patzf/Serial_Link_EMC_Demo/README.md

# Serial_Link_EMC_Demo
Run common serial interfaces across different cables
<!-- ! [Preview of PCB](hw/rendering1.png)  -->
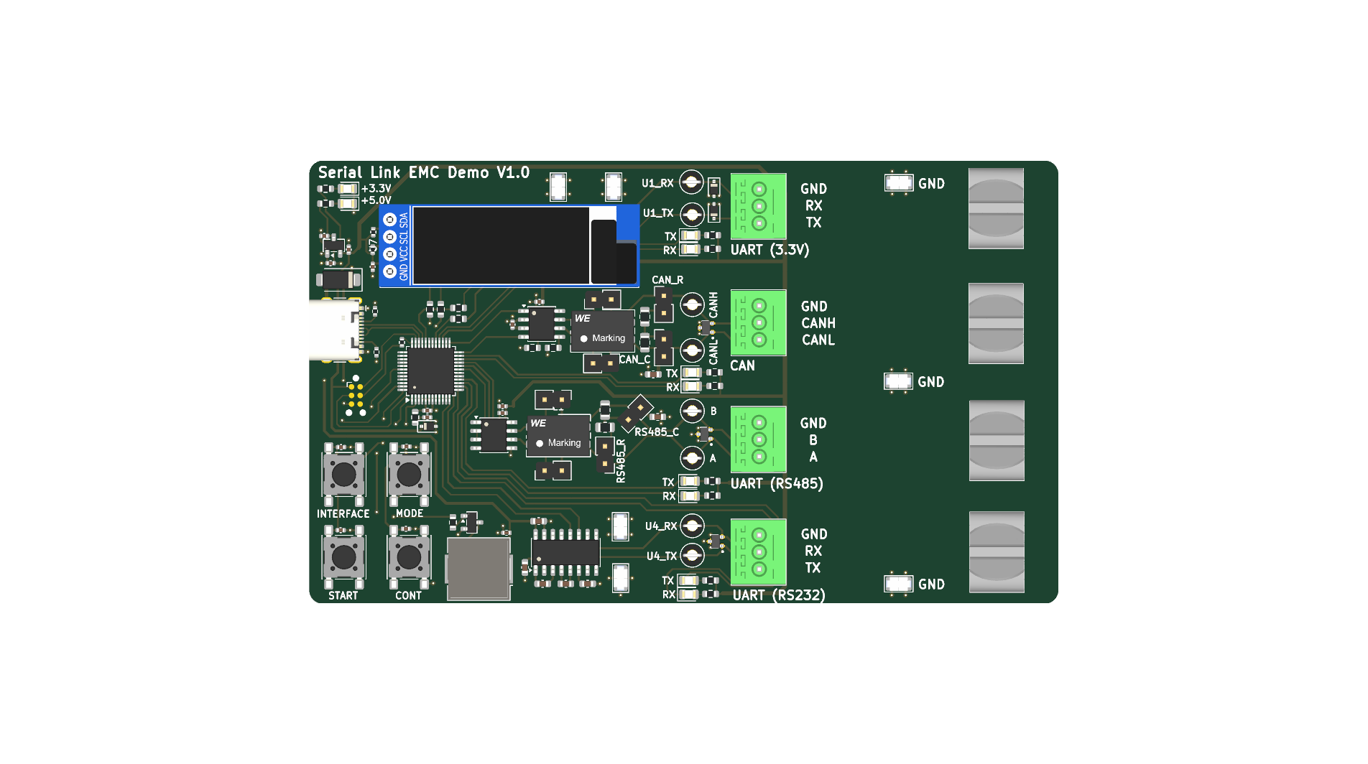
[picture p1: hw/Design-Outputs/pcb_rendering/main.png]
Preview of PCB
