patzf/Serial_Link_EMC_Demo/hw/img/catBW.png

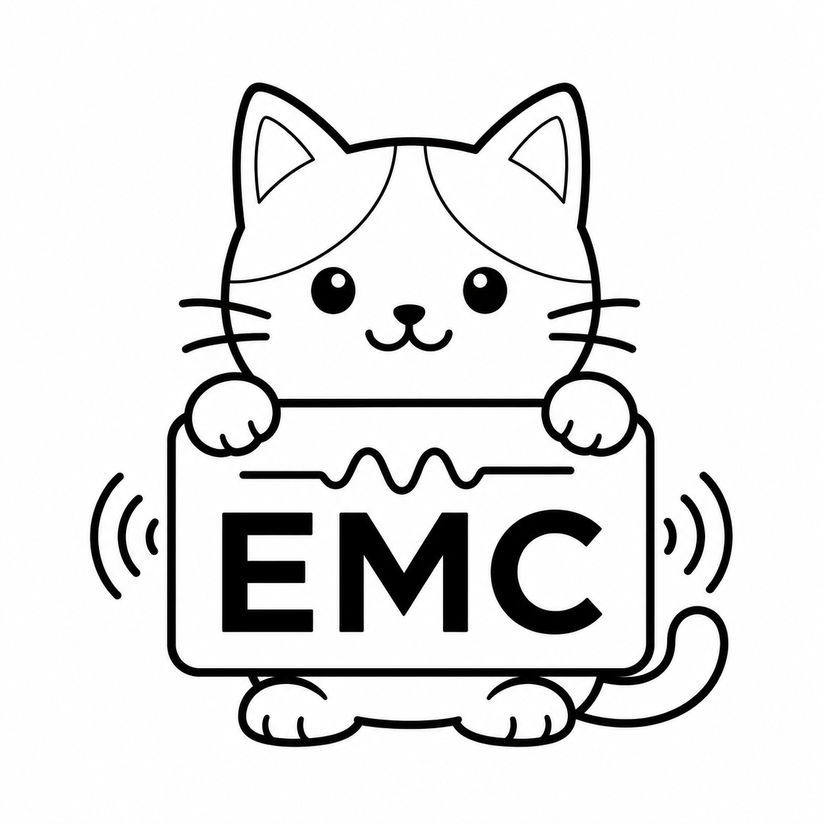
hw/img/catBW.png
