patzf/Serial_Link_EMC_Demo/hw/Design-Outputs/IFboard.pdf

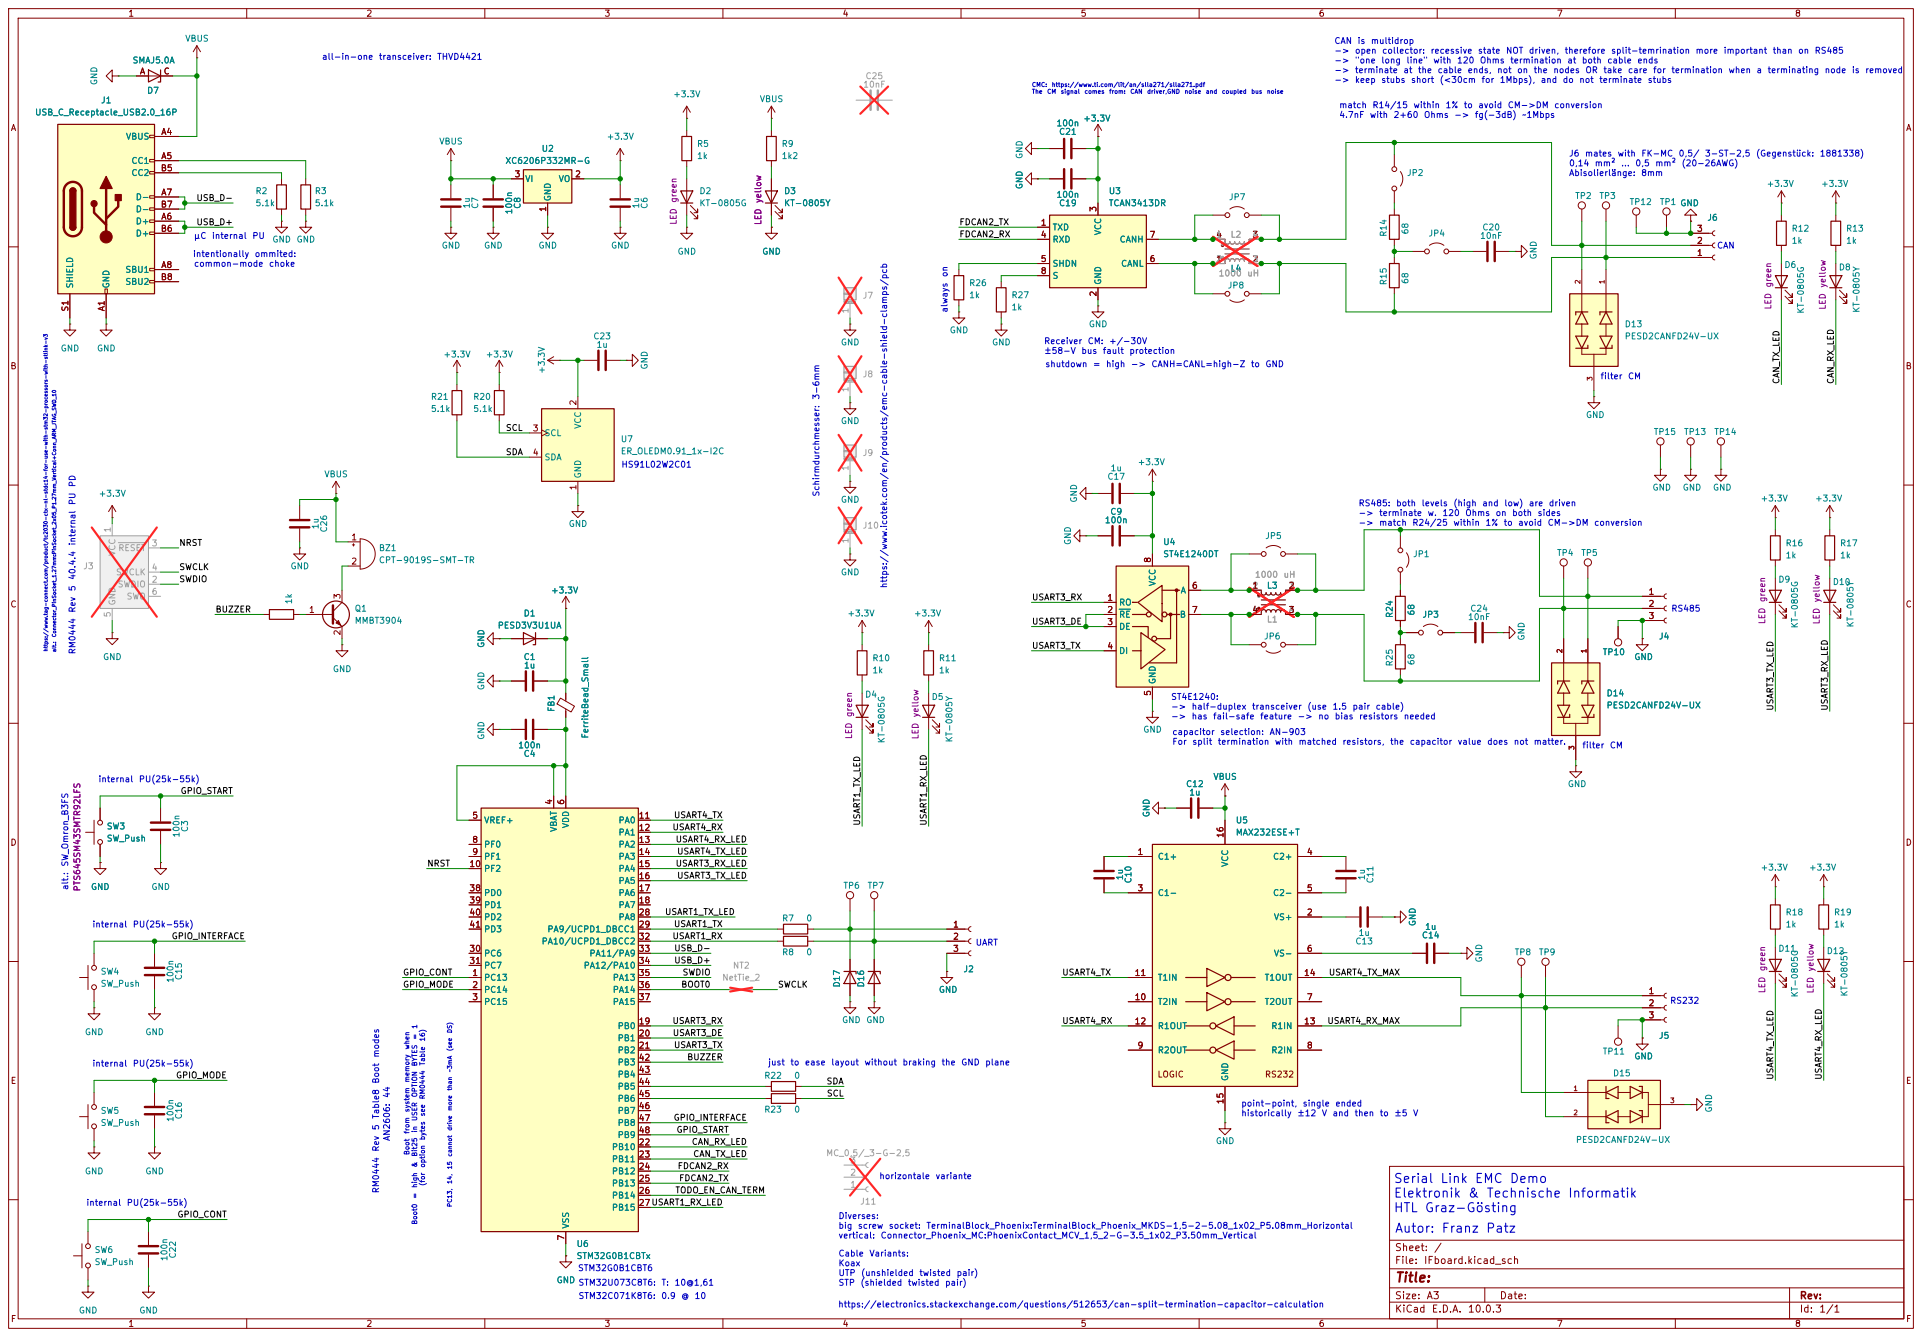
[picture p3: page 1]

all-in-one transceiver: THVD4421

match R14/15 within 1% to avoid CM->DM conversion 4.7nF with 2+60 Ohms -> fg(-3dB) ~1Mbps AN2606: 44

J6 mates with FK-MC 0,5/ 3-ST-2,5 (Gegenstück: 1881338)
0,14 mm² ... 0,5 mm² (20-26AWG)
Abisolierlänge: 8mm
TP3 GND

intentionally ommited: common-mode choke µC internal PU
internal PU(25k-55k) alt.: SW_Omron_B3FS https://www.tag-connect.com/product/tc2030-ctx-nl-stdc14-for-use-with-stm32-processors-with-stlink-v3

Receiver CM: +/-30V ±58-V bus fault protection always on https://www.icotek.com/en/products/emc-cable-shield-clamps/pcb

shutdown = high -> CANH=CANL=high-Z to GND

For split termination with matched resistors, the capacitor value does not matter. ST4E1240: -> half-duplex transceiver (use 1.5 pair cable) -> has fail-safe feature -> no bias resistors needed

filter CM Serial Link EMC Demo

UART https://electronics.stackexchange.com/questions/512653/can-split-termination-capacitor-calculation Diverses: big screw socket: TerminalBlock_Phoenix:TerminalBlock_Phoenix_MKDS-1,5-2-5.08_1x02_P5.08mm_Horizontal vertical: Connector_Phoenix_MC:PhoenixContact_MCV_1,5_2-G-3.5_1x02_P3.50mm_Vertical STM32G0B1CBT6

RS232 Boot from system memory when Boot0 = high & Bit25 in USER OPTION BYTES = 1 (for option bytes see RM0444 Table 16)

just to ease layout without braking the GND plane RM0444 Rev 5 Table8 Boot modes

point-point, single ended
historically ±12 V and then to ±5 V

Size: A3 | Rev:
KiCad E.D.A. 10.0.3 | Id: 1/1 | F Date:
