patzf/Serial_Link_EMC_Demo/hw/IFboard.kicad_pcb

## KiCad design hw/IFboard.kicad_pcb (2026-06-04)

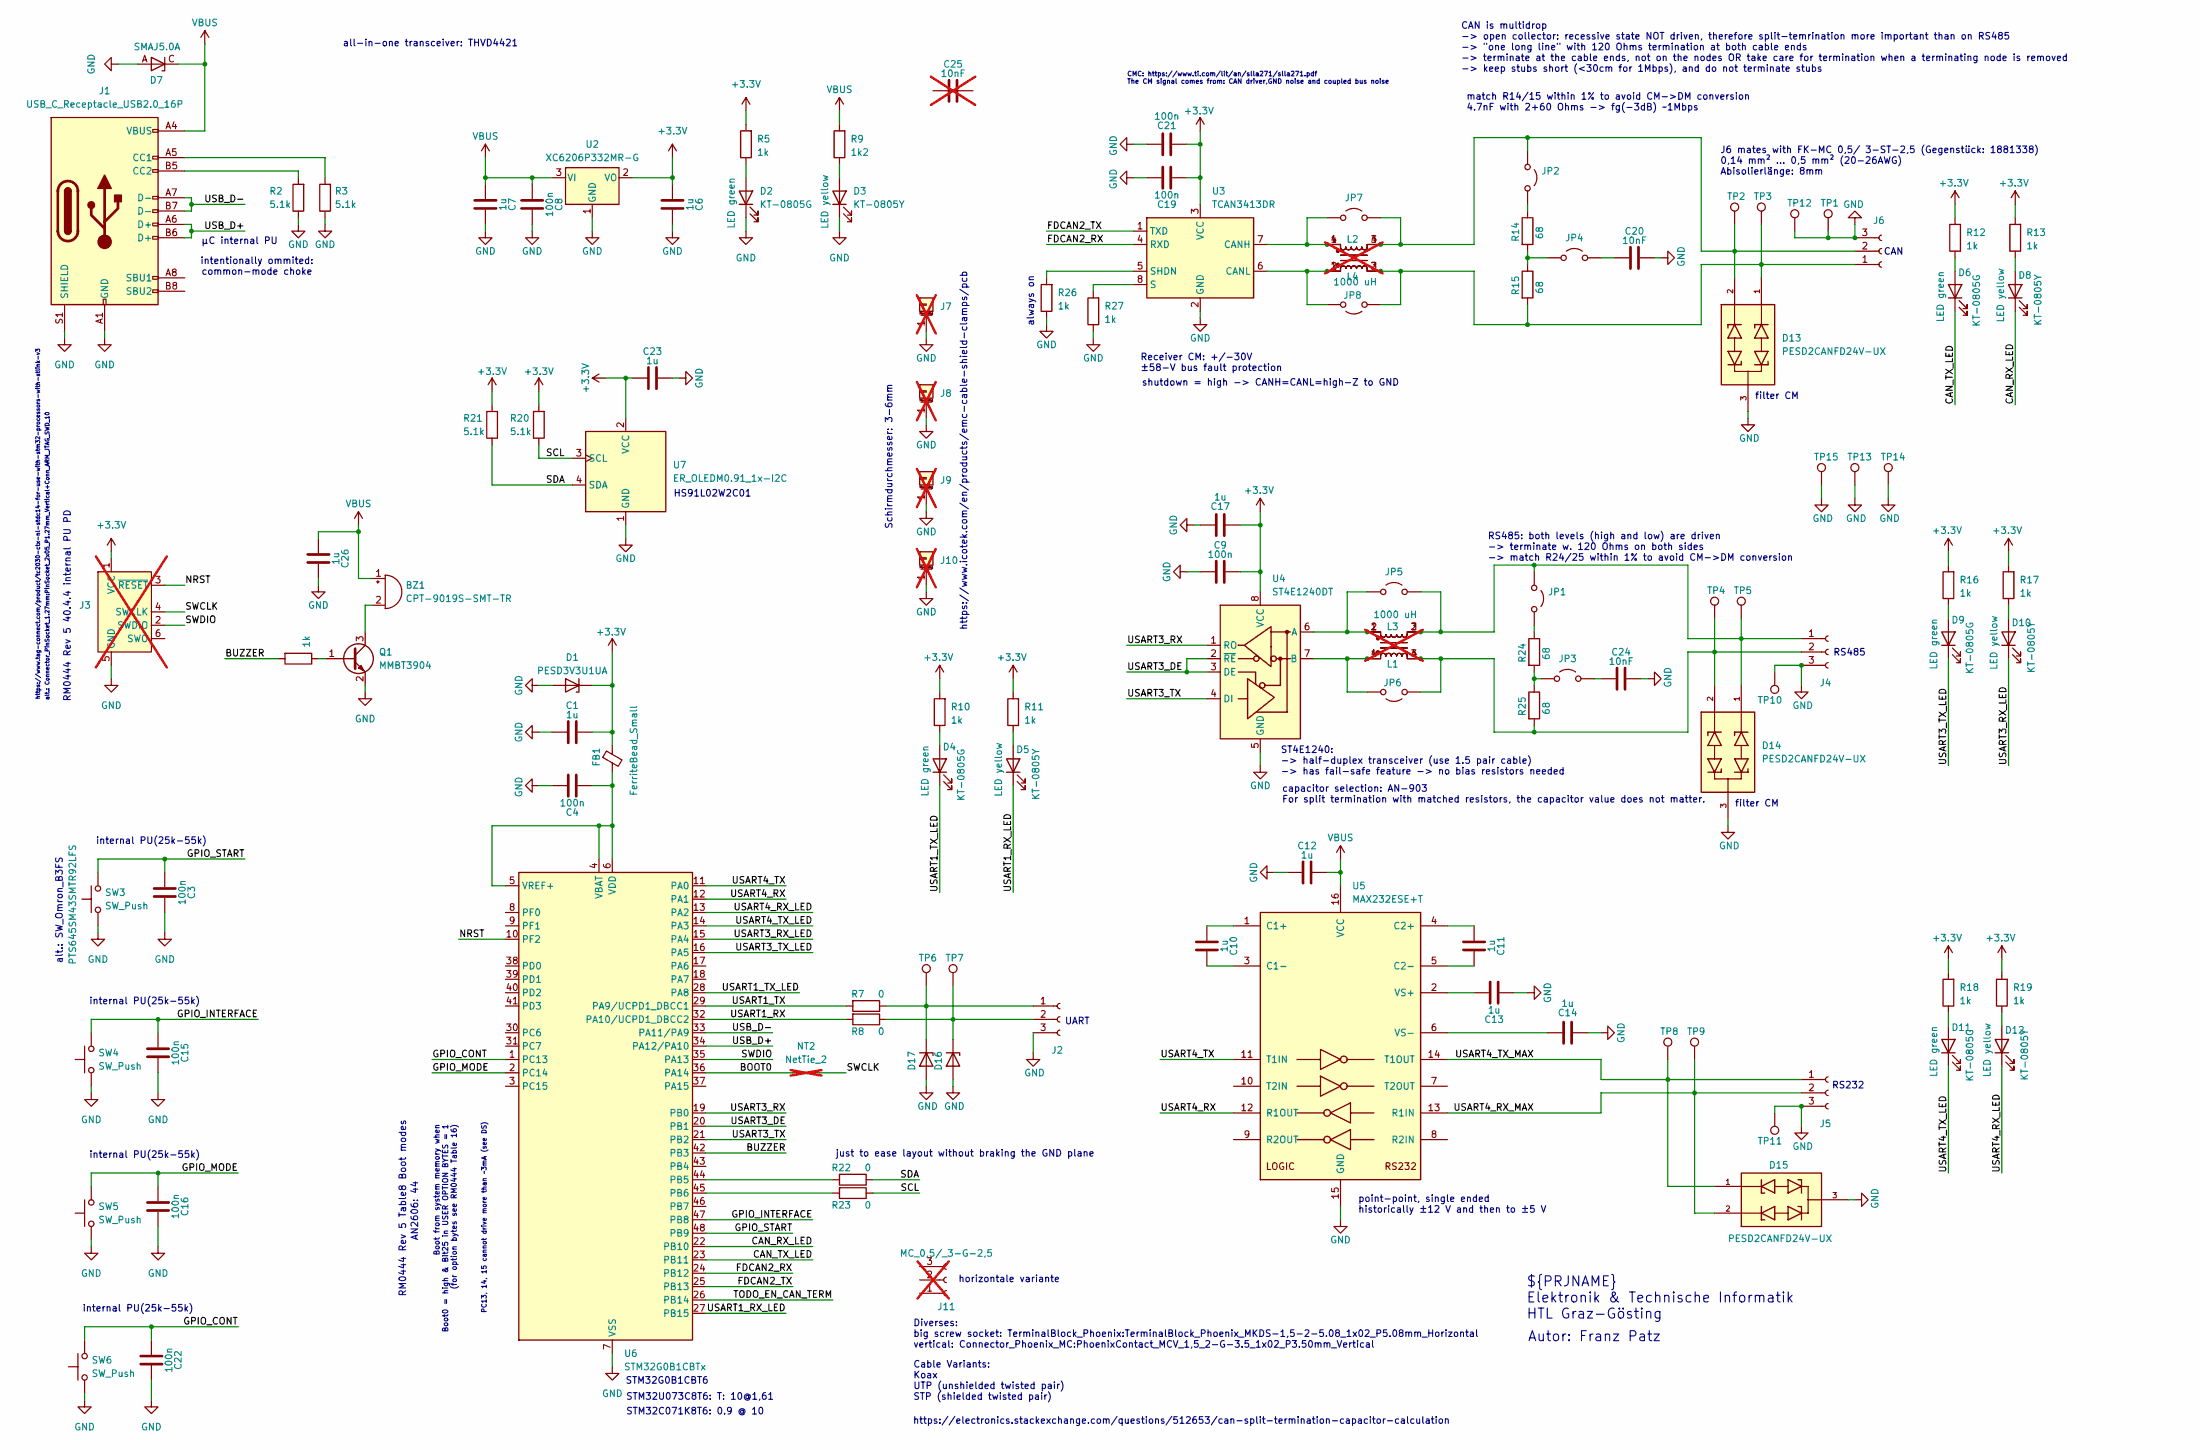
[picture p4: schematic IFboard.kicad_sch]

Parts:
BZ1: CPT-9019S-SMT-TR; Buzzer_CUI_CPT-9019S-SMT; LCSC Part # C95163
C1, C6, C7, C17, C23, C26: 1u; C_0402_1005Metric; LCSC Part # C52923
C3, C4, C8, C9, C15, C16, C19, C21, C22: 100n; C_0402_1005Metric; LCSC Part # C307331
C10, C11, C12, C13, C14: 1u; C_0603_1608Metric; LCSC Part # C15849
C20, C24: 10nF; C_0603_1608Metric; LCSC Part # C57112
C25: 10nF; C_0402_1005Metric; LCSC Part # C15195; not fitted
D1, D16, D17: PESD3V3U1UA; D_SOD-323; LCSC Part # C403915
D2, D4, D6, D9, D11: KT-0805G; LED_0805_2012Metric; LCSC Part # C2297
D3, D5, D8, D10, D12: KT-0805Y; LED_0805_2012Metric; LCSC Part # C2296
D7: SMAJ5.0A; D_SMA; LCSC Part # C2925443
D13, D14, D15: PESD2CANFD24V-UX; TVS_PESD2CANFD24V-UX; LCSC Part # C552487
FB1: FerriteBead_Small; R_0603_1608Metric; LCSC Part # C1002
J1: USB_C_Receptacle_USB2.0_16P; USB_C_Receptacle_HCTL_HC-TYPE-C-16P-01A; LCSC Part # C2894897
J2, J4, J5, J6: Phoenix_1881561; 1881561; LCSC Part # C3585554
J3: Conn_ARM_SWD_TagConnect_TC2030-NL; Tag-Connect_TC2030-IDC-NL_2x03_P1.27mm_Vertical; not fitted
J7, J8, J9, J10: IcoTec_36650.2; icotek 36650.2 PCB-4-V-6,8SKL 3-6; not fitted
J11: MC_0,5/_3-G-2,5; 1881451; not fitted
JP1, JP2, JP3, JP4, JP5, JP6, JP7, JP8: Jumper_2_Open; PinHeader_1x02_P2.54mm_Vertical; LCSC Part # C492401
L1, L2: 1000 uH; L_Wurth_WE-SL2-74422x; Part Number 744222; LCSC Part # C2651122; not fitted
L3, L4: 100 uH; L_Wurth_WE-CNSW-1812; LCSC Part # C2662370
NT2: NetTie_2; R_0402_1005Metric_solderjmp_short; not fitted
Q1: MMBT3904; SOT-23; LCSC Part # C7420353
R2, R3, R20, R21: 5.1k; R_0402_1005Metric; LCSC Part # C25905
R5, R10, R11, R12, R13, R16, R17, R18, R19, R26, R27, R29: 1k; R_0603_1608Metric; LCSC Part # C21190
R7, R8, R22, R23: 0; R_0603_1608Metric; LCSC Part # C21189
R9: 1k2; R_0603_1608Metric; LCSC Part # C22765
R14, R15, R24, R25: 68; R_0805_2012Metric; LCSC Part # C17802
SW3, SW4, SW5, SW6: SW_Push; SW_SPST_PTS645Sx43SMTR92; LCSC Part # C221880
TP1, TP10, TP11, TP12, TP13, TP14, TP15: TestPoint_Keystone_5019; TestPoint_Keystone_5019_Miniature; LCSC Part # C238131
TP2, TP3, TP4, TP5, TP6, TP7, TP8, TP9: TestPoint; TP_Keystone_5010-5014_Multipurpose; LCSC Part # C2906765
U2: XC6206P332MR-G; SOT-23-3; LCSC Part # C5446
U3: TCAN3413DR; SOIC-8_3.9x4.9mm_P1.27mm; LCSC Part # C22433320
U4: ST4E1240DT; SOIC-8_3.9x4.9mm_P1.27mm; LCSC Part # C29603430
U5: MAX232ESE+T; SOIC-16_3.9x9.9mm_P1.27mm; LCSC Part # C26860
U6: STM32G0B1CBTx; LQFP-48_7x7mm_P0.5mm; LCSC Part # C2847904
U7: ER_OLEDM0.91_1x-I2C; LCSC Part # C5248081

Connections:
+3.3V: C1.1, C6.2, C9.1, C17.2, C19.2, C21.2, C23.2, D1.1 (K), FB1.1, J3.1 (VCC), R5.2, R10.2, R11.2, R12.2, R13.2, R16.2, R17.2, R18.2, R19.2, R20.2, R21.2, U2.2 (VO), U3.3 (VCC), U4.8 (VCC), U7.2 (VCC)
/BOOT0: NT2.1, U6.36 (PA14)
/BUZZER: R29.2, U6.42 (PB3)
/CAN_RX_LED: D8.1 (K), U6.22 (PB10)
/CAN_TX_LED: D6.1 (K), U6.23 (PB11)
/FDCAN2_RX: U3.4 (RXD), U6.24 (PB12)
/FDCAN2_TX: U3.1 (TXD), U6.25 (PB13)
/GPIO_CONT: C22.2, SW6.2, U6.1 (PC13)
/GPIO_INTERFACE: C15.2, SW4.2, U6.47 (PB8)
/GPIO_MODE: C16.2, SW5.2, U6.2 (PC14)
/GPIO_START: C3.2, SW3.2, U6.48 (PB9)
/NRST: J3.3 (~RESET), U6.10 (PF2)
/SCL: R20.1, R23.1, U7.3 (SCL)
/SDA: R21.1, R22.1, U7.4 (SDA)
/SWCLK: J3.4 (SWCLK), NT2.2
/SWDIO: J3.2 (SWDIO), U6.35 (PA13)
/TODO_EN_CAN_TERM: U6.26 (PB14)
/USART1_RX: R8.2, U6.32 (PA10/UCPD1_DBCC2)
/USART1_RX_LED: D5.1 (K), U6.27 (PB15)
/USART1_TX: R7.2, U6.29 (PA9/UCPD1_DBCC1)
/USART1_TX_LED: D4.1 (K), U6.28 (PA8)
/USART3_DE: U4.2 (~RE), U4.3 (DE), U6.20 (PB1)
/USART3_RX: U4.1 (RO), U6.19 (PB0)
/USART3_RX_LED: D10.1 (K), U6.15 (PA4)
/USART3_TX: U4.4 (DI), U6.21 (PB2)
/USART3_TX_LED: D9.1 (K), U6.16 (PA5)
/USART4_RX: U5.12 (R1OUT), U6.12 (PA1)
/USART4_RX_LED: D12.1 (K), U6.13 (PA2)
/USART4_RX_MAX: D15.2, J5.2, TP9.1 (1_1), U5.13 (R1IN)
/USART4_TX: U5.11 (T1IN), U6.11 (PA0)
/USART4_TX_LED: D11.1 (K), U6.14 (PA3)
/USART4_TX_MAX: D15.1, J5.1, TP8.1 (1_1), U5.14 (T1OUT)
/USB_D+: J1.A6 (D+), J1.B6 (D+), U6.34 (PA12/PA10)
/USB_D-: J1.A7 (D-), J1.B7 (D-), U6.33 (PA11/PA9)
GND: C1.2, C3.1, C4.1, C6.1, C7.1, C8.1, C9.2, C12.2, C13.2, C14.2, C15.1, C16.1, C17.1, C19.1, C20.1, C21.1, C22.1, C23.1, C24.1, C26.1, D1.2 (A), D2.1 (K), D3.1 (K), D7.A, D13.3, D14.3, D15.3, D16.2 (A), D17.2 (A), J1.A1 (GND), J1.A12 (GND), J1.B1 (GND), J1.B12 (GND), J1.S1 (SHIELD), J2.3, J3.5 (GND), J4.3, J5.3, J6.3, J7.1 (MountPin_1), J8.1 (MountPin_1), J9.1 (MountPin_1), J10.1 (MountPin_1), Q1.2 (E), R2.1, R3.1, R26.1, R27.1, SW3.1, SW4.1, SW5.1, SW6.1, TP1.1 (1_1), TP10.1 (1_1), TP11.1 (1_1), TP12.1 (1_1), TP13.1 (1_1), TP14.1 (1_1), TP15.1 (1_1), U2.1 (GND), U3.2 (GND), U4.5 (GND), U5.15 (GND), U6.7 (VSS), U7.1 (GND)
unnamed: BZ1.2 (-), Q1.3 (C)
unnamed: D2.2 (A), R5.1
unnamed: D3.2 (A), R9.1
unnamed: D4.2 (A), R10.1
unnamed: D5.2 (A), R11.1
unnamed: D6.2 (A), R12.1
unnamed: D8.2 (A), R13.1
unnamed: D9.2 (A), R16.1
unnamed: D10.2 (A), R17.1
unnamed: D11.2 (A), R18.1
unnamed: D12.2 (A), R19.1
unnamed: D16.1 (K), J2.2, R8.1, TP7.1 (1_1)
unnamed: D17.1 (K), J2.1, R7.1, TP6.1 (1_1)
unnamed: J1.A5 (CC1), R3.2
unnamed: J1.B5 (CC2), R2.2
unnamed: D14.1, J4.1, JP1.1 (A), JP5.2 (B), L1.3, L3.2, TP5.1 (1_1)
unnamed: D14.2, J4.2, JP6.1 (A), L1.4, L3.3, R25.2, TP4.1 (1_1)
unnamed: D13.1, J6.1, JP8.1 (A), L2.3, L4.2, R15.2, TP3.1 (1_1)
unnamed: D13.2, J6.2, JP2.1 (A), JP7.2 (B), L2.4, L4.3, TP2.1 (1_1)
unnamed: JP1.2 (B), R24.1
unnamed: JP2.2 (B), R14.1
unnamed: JP3.1 (A), R24.2, R25.1
unnamed: C24.2, JP3.2 (B)
unnamed: JP4.1 (A), R14.2, R15.1
unnamed: C20.2, JP4.2 (B)
unnamed: JP5.1 (A), L1.2, L3.1, U4.6 (A)
unnamed: JP6.2 (B), L1.1, L3.4, U4.7 (B)
unnamed: JP7.1 (A), L2.1, L4.4, U3.7 (CANH)
unnamed: JP8.2 (B), L2.2, L4.1, U3.6 (CANL)
unnamed: Q1.1 (B), R29.1
unnamed: R27.2, U3.8 (S)
unnamed: R26.2, U3.5 (SHDN)
unnamed: C10.2, U5.1 (C1+)
unnamed: C10.1, U5.3 (C1-)
unnamed: C11.2, U5.4 (C2+)
unnamed: C11.1, U5.5 (C2-)
unnamed: C13.1, U5.2 (VS+)
unnamed: C14.1, U5.6 (VS-)
unnamed: R22.2, U6.44 (PB5)
unnamed: R23.2, U6.45 (PB6)
unnamed: C4.2, FB1.2, U6.4 (VBAT), U6.5 (VREF+), U6.6 (VDD)
VBUS: BZ1.1 (+), C7.2, C8.2, C12.1, C26.2, D7.C, J1.A4 (VBUS), J1.A9 (VBUS), J1.B4 (VBUS), J1.B9 (VBUS), R9.2, U2.3 (VI), U5.16 (VCC)

Notes on the sheet:
shutdown = high -> CANH=CANL=high-Z to GND
horizontale variante
RS485
alt.: Connector_PinSocket_1.27mm:PinSocket_2x05_P1.27mm_Vertical+Conn_ARM_JTAG_SWD_10
HS91L02W2C01
STM32U073C8T6: T: 10@1,61
capacitor selection: AN-903 For split termination with matched resistors, the capacitor value does not matter.
internal PU(25k-55k)
CMC: https://www.ti.com/lit/an/slla271/slla271.pdf The CM signal comes from: CAN driver,GND noise and coupled bus noise
Diverses: big screw socket: TerminalBlock_Phoenix:TerminalBlock_Phoenix_MKDS-1,5-2-5.08_1x02_P5.08mm_Horizontal vertical: Connector_Phoenix_MC:PhoenixContact_MCV_1,5_2-G-3.5_1x02_P3.50mm_Vertical
PC13, 14, 15 cannot drive more than ~3mA (see DS)
intentionally ommited: common-mode choke
J6 mates with FK-MC 0,5/ 3-ST-2,5 (Gegenstück: 1881338) 0,14 mm² ... 0,5 mm² (20-26AWG) Abisolierlänge: 8mm
CAN is multidrop -> open collector: recessive state NOT driven, therefore split-temrination more important than on RS485 -> "one long line" with 120 Ohms termination at both cable ends -> terminate at the cable ends, not on the nodes OR take care for termination when a terminating node is removed -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
filter CM
https://electronics.stackexchange.com/questions/512653/can-split-termination-capacitor-calculation
RM0444 Rev 5 40.4.4 internal PU PD
STM32G0B1CBT6
Boot from system memory when Boot0 = high & Bit25 in USER OPTION BYTES = 1 (for option bytes see RM0444 Table 16)
all-in-one transceiver: THVD4421
Schirmdurchmesser: 3-6mm
RS485: both levels (high and low) are driven -> terminate w. 120 Ohms on both sides -> match R24/25 within 1% to avoid CM->DM conversion
https://www.tag-connect.com/product/tc2030-ctx-nl-stdc14-for-use-with-stm32-processors-with-stlink-v3
STM32C071K8T6: 0.9 @ 10
µC internal PU
always on
RM0444 Rev 5 Table8 Boot modes
ST4E1240: -> half-duplex transceiver (use 1.5 pair cable) -> has fail-safe feature -> no bias resistors needed
UART
Autor: Franz Patz
alt.: SW_Omron_B3FS
Receiver CM: +/-30V ±58-V bus fault protection
CAN
Cable Variants: Koax UTP (unshielded twisted pair) STP (shielded twisted pair)
match R14/15 within 1% to avoid CM->DM conversion 4.7nF with 2+60 Ohms -> fg(-3dB) ~1Mbps
point-point, single ended historically ±12 V and then to ±5 V
AN2606: 44
RS232
${PRJNAME} Elektronik & Technische Informatik HTL Graz-Gösting
https://www.icotek.com/en/products/emc-cable-shield-clamps/pcb
just to ease layout without braking the GND plane

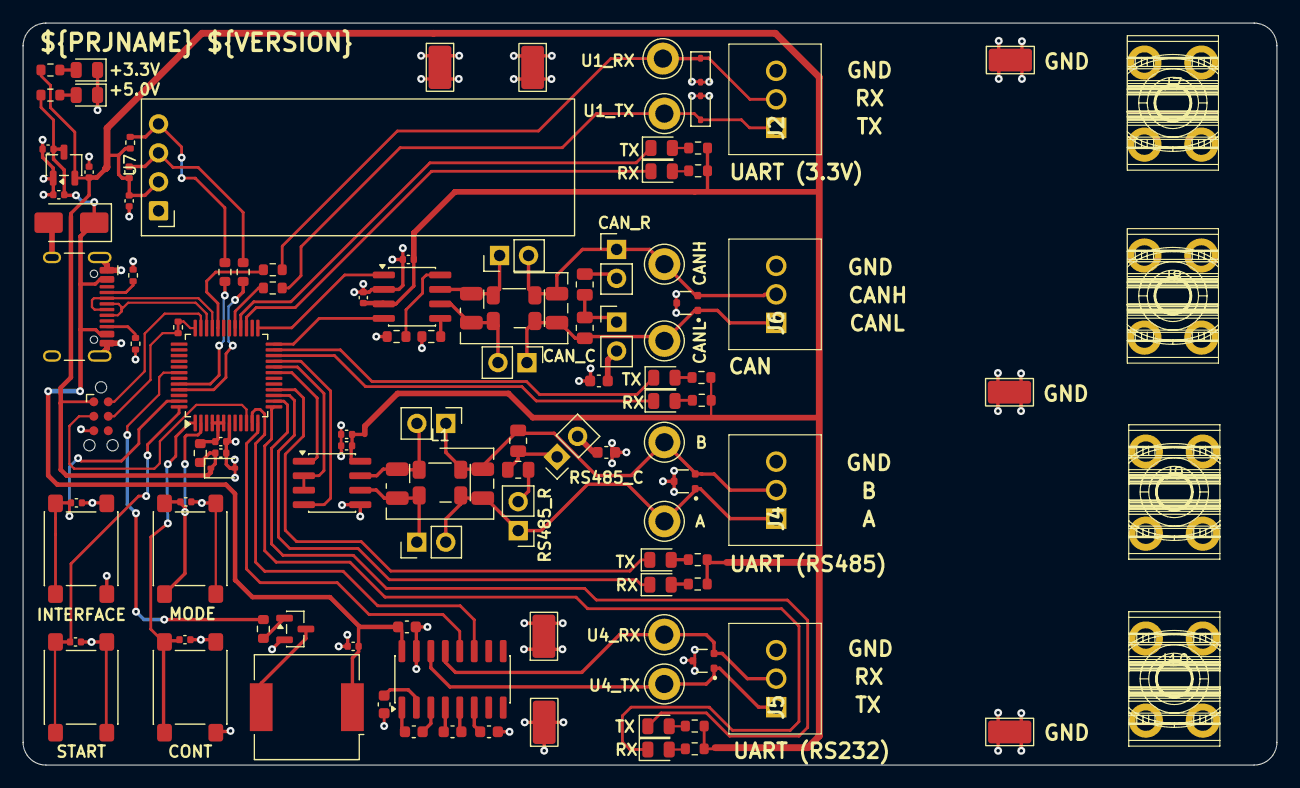
[picture p5: board IFboard.kicad_pcb from above]

Board: 2 copper layers, 110.0 x 65.1 mm, 115 parts (0 on the bottom side), 76 nets.
