patzf/Serial_Link_EMC_Demo/fw/Core/Src/main.c

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
/* Includes ------------------------------------------------------------------*/
#include "main.h"
#include "fdcan.h"
#include "i2c.h"
#include "tim.h"
#include "usart.h"
#include "usb_drd_fs.h"
#include "gpio.h"

/* USER CODE BEGIN Includes */

#include <buttons.h>
#include <ssd1306.h>
#include <ssd1306_fonts.h>

/* USER CODE END Includes */

/* USER CODE BEGIN PD */

#define STANDARD_DATA 0x9A

/* USER CODE END PD */


/* USER CODE BEGIN PV */
uint32_t tx_byte_cnt = 0;
/* USER CODE END PV */

void SystemClock_Config(void);
/* USER CODE BEGIN PFP */
unsigned int rand(unsigned int* seed);
HAL_StatusTypeDef transmit(uint8_t data);
HAL_StatusTypeDef receive(uint8_t* data);
int countSetBits(unsigned int num);
/* USER CODE END PFP */

/**
  * @brief  The application entry point.
  * @retval int
  */
int main(void)
{

  /* MCU Configuration--------------------------------------------------------*/

  /* Reset of all peripherals, Initializes the Flash interface and the Systick. */
  HAL_Init();

  /* Configure the system clock */
  SystemClock_Config();

  /* Initialize all configured peripherals */
  MX_GPIO_Init();
  MX_USART1_UART_Init();
  MX_USART3_UART_Init();
  MX_USART4_UART_Init();
  MX_FDCAN2_Init();
  MX_USB_DRD_FS_PCD_Init();
  MX_TIM6_Init();
  MX_I2C1_Init();
  /* Infinite loop */
  /* USER CODE BEGIN WHILE */

  unsigned int transmitSeed = 0;
  unsigned int receiveSeed = 0;

  unsigned int receiveErrors = 0;


  ssd1306_Init();

  ssd1306_Fill(Black);
  ssd1306_SetCursor(0, 0);
  ssd1306_WriteString("Interface: UART", Font_7x10, White);
  ssd1306_SetCursor(0, 11);
  ssd1306_WriteString("Mode: TX", Font_7x10, White);
  ssd1306_SetCursor(0, 22);
  ssd1306_WriteString("Byte Count: ", Font_7x10, White);
  ssd1306_UpdateScreen();


  char buffer[6];


  while (1)
  {
	  if (resetRNG) {
		  transmitSeed = 0;
		  receiveSeed = 0;
		  resetRNG = 0;
	  }

	  if ((role == TRANSMIT || role == RECEIVE_TRANSMIT) && running) {
		  uint8_t data = STANDARD_DATA;
		  if (sendMode == CONTINUOUS_SEND_MODE)
			  data = rand(&transmitSeed) % 256;
		  transmit(data);
		  tx_byte_cnt++;


		  //put to function
		  ssd1306_SetCursor(100, 22); // 20 ok
		  snprintf(buffer, sizeof(buffer), "%d", tx_byte_cnt);
		  ssd1306_WriteString(buffer, Font_7x10, White);
		  ssd1306_UpdateScreen();
	  }

	  if (role == RECEIVE || role == RECEIVE_TRANSMIT) {
		  uint8_t data = 0;
		  if (receive(&data) == HAL_OK) {
			  uint8_t expected = STANDARD_DATA;
			  if (sendMode == CONTINUOUS_SEND_MODE)
				  expected = rand(&receiveSeed) % 256;
			  receiveErrors += countSetBits(expected ^ data);
		  }
	  }
  }


    /* USER CODE END WHILE */

}

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
/* USER CODE BEGIN 4 */

unsigned int rand(unsigned int* seed) {
	*seed = *seed * 1103515243 + 12345;
    return (unsigned int)(*seed / 65536) % 32768;
}

HAL_StatusTypeDef transmit(uint8_t data) {
	switch (currInterface) {
	case UART_RS232_INTERFACE: return HAL_UART_Transmit(&huart4, &data, 1, 10); // UART4
	case UART_RS485_INTERFACE: return HAL_UART_Transmit(&huart3, &data, 1, 10);  // UART3
	case UART_3V3_INTERFACE: HAL_UART_Transmit(&huart1, &data, 1, 10); // UART1
	case CAN_INTERFACE: return ERROR;
	}
	return ERROR;
}

HAL_StatusTypeDef receive(uint8_t* data) {
	switch (currInterface) {
	case UART_RS232_INTERFACE: return HAL_UART_Receive(&huart4, data, 1, 10); // UART4
	case UART_RS485_INTERFACE: return HAL_UART_Receive(&huart3, data, 1, 10);  // UART3
	case UART_3V3_INTERFACE: return HAL_UART_Receive(&huart1, data, 1, 10); // UART1
	case CAN_INTERFACE: return ERROR;
	}
	return ERROR;
}

int countSetBits(unsigned int num)
{
    int count = 0;
    while (num) {
        num &= (num - 1); // Turn off the rightmost set bit
        count++;
    }
    return count;
}

/* USER CODE END 4 */
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
