patzf/Serial_Link_EMC_Demo/fw/main.ioc

Mcu.UserName=STM32G0B1CBTx
PA0.Signal=USART4_TX
PA1.Signal=USART4_RX
PA10.Signal=USART1_RX
PA9.Signal=USART1_TX
PB0.Signal=USART3_RX
PB1.Signal=USART3_DE
PB12.Signal=FDCAN2_RX
PB13.Signal=FDCAN2_TX
PB2.Signal=USART3_TX
PB5.GPIO_Label=DONOTUSE
PB5.Signal=GPIO_Input
PB6.Signal=I2C1_SCL
PB7.Signal=I2C1_SDA
PB8.GPIO_Label=INTERFACE
PB8.Signal=GPXTI8
PB9.GPIO_Label=START
PB9.Signal=GPXTI9
PC13.GPIO_Label=CONT
PC13.Signal=GPXTI13
