patzf/Serial_Link_EMC_Demo/fw/Core/Inc/main.h

#define CONT_Pin GPIO_PIN_13
#define CONT_GPIO_Port GPIOC
#define CONT_EXTI_IRQn EXTI4_15_IRQn
#define MODE_Pin GPIO_PIN_14
#define MODE_GPIO_Port GPIOC
#define MODE_EXTI_IRQn EXTI4_15_IRQn
#define DONOTUSE_Pin GPIO_PIN_5
#define DONOTUSE_GPIO_Port GPIOB
#define INTERFACE_Pin GPIO_PIN_8
#define INTERFACE_GPIO_Port GPIOB
#define INTERFACE_EXTI_IRQn EXTI4_15_IRQn
#define START_Pin GPIO_PIN_9
#define START_GPIO_Port GPIOB
#define START_EXTI_IRQn EXTI4_15_IRQn
