patzf/Serial_Link_EMC_Demo/(commit log)

2026-05-09 copied all parts into personal lib to have JLC numbers added per default
    [IFboard.kicad_pcb, IFboard.kicad_sch]
2026-05-10 wip:add small display
    [IFboard.kicad_pcb, IFboard.kicad_sch]
2026-05-11 display I2C connection done. not proud of it =)
    [IFboard.kicad_pcb, IFboard.kicad_sch]
2026-05-13 forgot last time
    [IFboard.kicad_pcb, IFboard.kicad_sch]
2026-05-13 tag:3.5mm connectors
    [1952270.stp, 36650_2.stp, 36650_2_top.dxf, IFboard.kicad_pcb, IFboard.kicad_sch]
2026-05-14 swapped poition of two connectors for better routing
    [IFboard.kicad_pcb, IFboard.kicad_sch]
2026-05-15 added CMCs to RS485 and CAN interfaces
    [IFboard.kicad_pcb, IFboard.kicad_sch, L_Wurth_WE-SL2-74422x.step]
2026-05-16 changed position of SMSs and added TVS diodes to RS485 and CAN
    [IFboard.kicad_pcb, IFboard.kicad_sch, PESD2CANFD24V-UX.step]
2026-05-20 added jumper to add/remove split-termination capacitors
    [IFboard.kicad_pcb, IFboard.kicad_sch]
2026-05-26 train session
    [IFboard.kicad_pcb, IFboard.kicad_sch]
2026-05-28 modified connectors to vertical
    [IFboard.kicad_pcb, IFboard.kicad_sch]
2026-05-29 moving pdfs to ds directory
    [36650_2_top.dxf]
2026-06-01 added jumpers to be able to short CMCs
    [IFboard.kicad_pcb, IFboard.kicad_sch]
2026-06-02 corrected rotation offsets for JLC
    [IFboard.kicad_pcb, IFboard.kicad_sch]
2026-06-04 first version sent to JLC
    [IFboard.kicad_pcb, IFboard.kicad_sch]
2026-06-05 modified gitignore to keep csv production data under Version control
    [bom.csv, designators.csv, positions.csv]
2026-06-18 merged display code - display functional after fixing error in HW (SDA must go to PB7 instead of PB5)
    [buttons.c, buttons.h]
2026-06-19 few lines hacked so a counter is shown on the display when sending data over UART1 to check basic TX/RX functionality
